Ennnnnnnnnnnnnnnnnnn/MyBalanceVehicle/Hardware/pcb.png

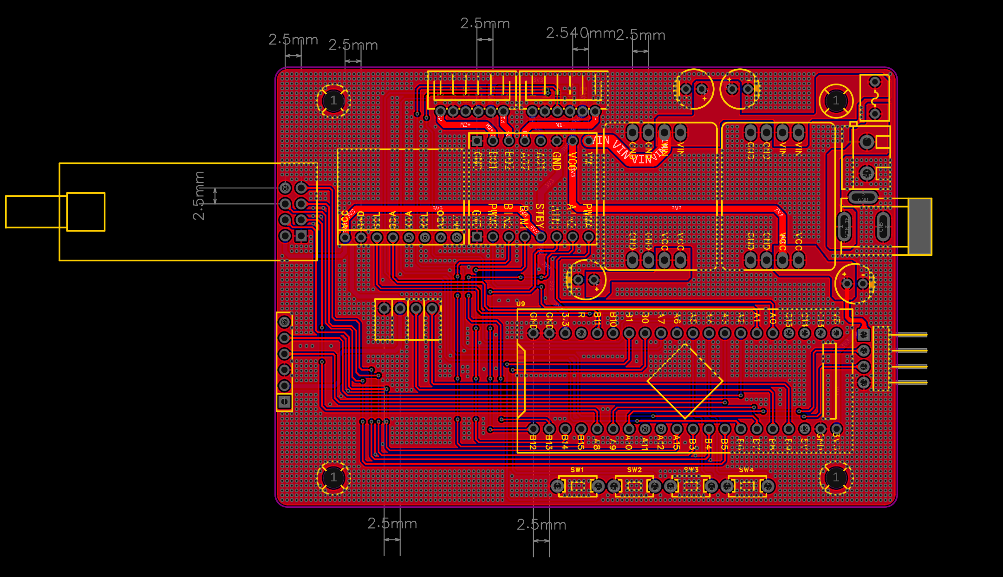
Hardware/pcb.png
