Ennnnnnnnnnnnnnnnnnn/MyBalanceVehicle/Hardware/schematic.png

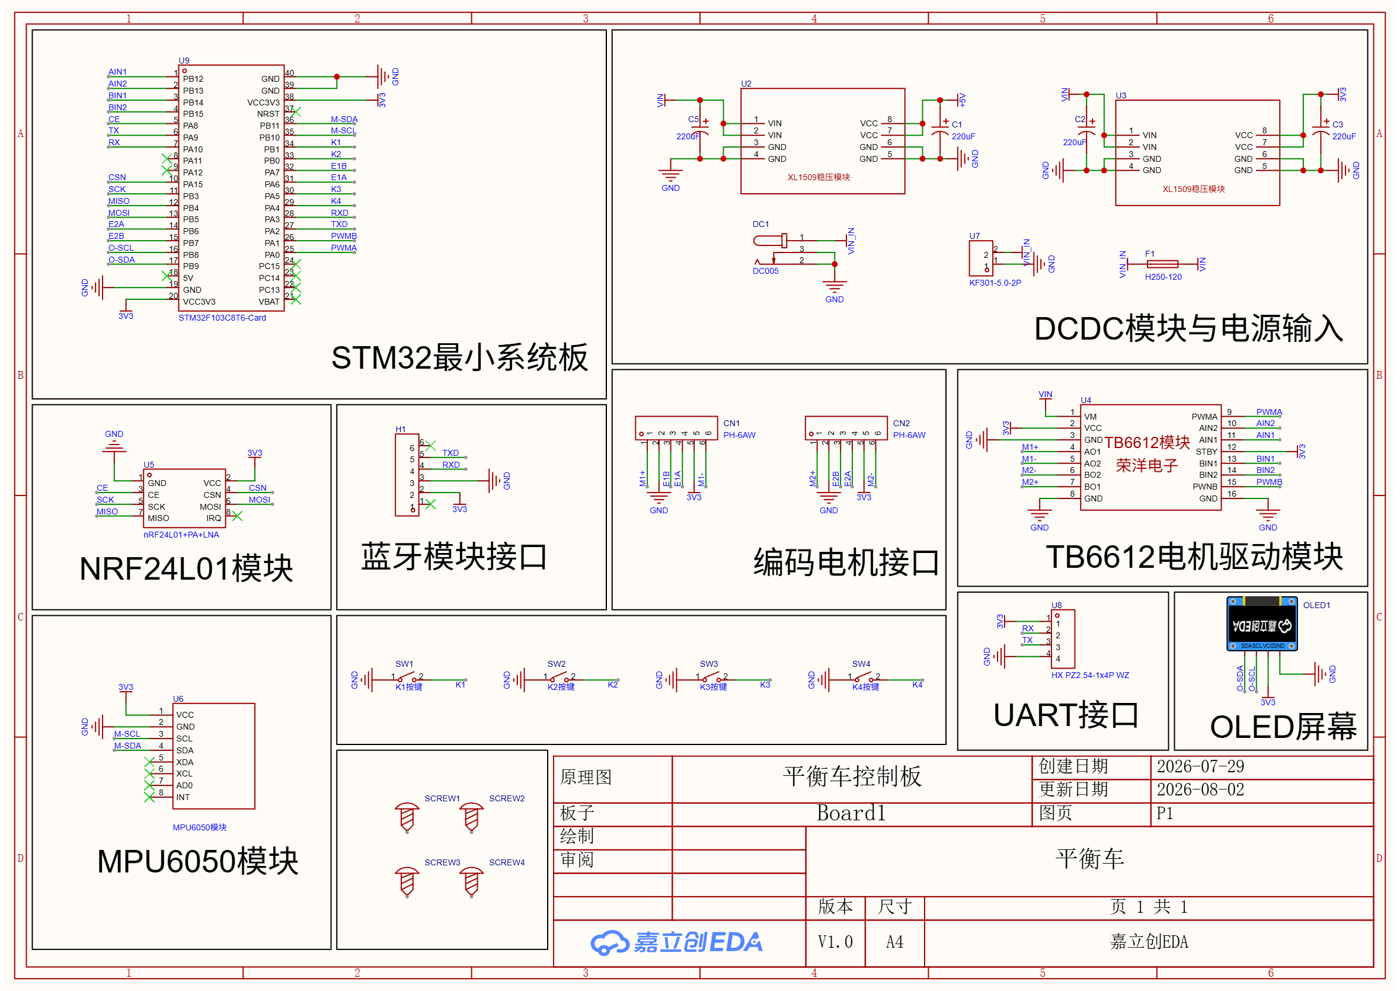
Hardware/schematic.png
