Ennnnnnnnnnnnnnnnnnn/MyBalanceVehicle/Hardware/BOM.xlsx

No. | Quantity | Comment | Designator | Footprint | Value | Manufacturer Part | Manufacturer | Supplier Part | Supplier
1 | 4 | 220uF | C1,C2,C3,C5 | CAP-TH_BD6.3-P2.50-D0.5-FD | 220uF | ERG25V220M6X11 | JIERR(捷而瑞) | C47344177 | LCSC
2 | 2 | PH-6AW | CN1,CN2 | CONN-TH_6P-P2.00_HCTL_PH-6AW |  | PH-6AW | HCTL(华灿天禄) | C2908638 | LCSC
3 | 1 | DC005 | DC1 | DC-IN-TH_DC005 |  | DC005 | SHOU HAN(首韩) | C431533 | LCSC
4 | 1 | H250-120 | F1 | FUSE-TH_L7.0-W4.5-P5.10-D0.6 |  | H250-120 | R+O(宏嘉诚) | C49166736 | LCSC
5 | 1 | HDR-F_2.54_1x6P | H1 | HDR-TH_6P-P2.54-V-F |  |  |  | C40877
6 | 1 | 0.96OLED模块_4P | OLED1 | 0.96OLED_4P
7 | 4 | M3螺丝 | SCREW1,SCREW2,SCREW3,SCREW4 | M3螺丝
8 | 1 | K1按键 | SW1 | SW-TH_L6.0-W3.3-P6.50 |  | K1按键 | Yuandi(元迪) | C492996 | LCSC
9 | 1 | K2按键 | SW2 | SW-TH_L6.0-W3.3-P6.50 |  | K2按键 | Yuandi(元迪) | C492996 | LCSC
10 | 1 | K3按键 | SW3 | SW-TH_L6.0-W3.3-P6.50 |  | K3按键 | Yuandi(元迪) | C492996 | LCSC
11 | 1 | K4按键 | SW4 | SW-TH_L6.0-W3.3-P6.50 |  | K4按键 | Yuandi(元迪) | C492996 | LCSC
12 | 2 | XL1509降压模块 | U2,U3 | XL1509-5.0降压模块
13 | 1 | TB6612模块 | U4 | tb6612模块
14 | 1 | nRF24L01+PA+LNA | U5 | COMM-TH_L41.0-W15.5-P2.54_NRF24L01 |  | nRF24L01+PA+LNA |  | C9900187674 | LCSC
15 | 1 | MPU6050模块 | U6 | MPU6050 | MPU6050模块
16 | 1 | KF301-5.0-2P | U7 | CONN-TH_P5.00_KF301-5.0-2P |  | KF301-5.0-2P | KEFA(科发) | C474881 | LCSC
17 | 1 | HX PZ2.54-1x4P WZ | U8 | HDR-TH_4P-P2.54-H-M-W10.3 |  | HX PZ2.54-1x4P WZ | hanxia(韩下) | C32713263 | LCSC
18 | 1 | STM32F103C8T6-Card | U9 | CONN-TH_L53.3-W22.9_STM32F103C8T6-CARD |  | STM32F103C8T6-Card |  | C9900077949 | LCSC
