Ennnnnnnnnnnnnnnnnnn/MyBalanceVehicle/Hardware/schematic.pdf

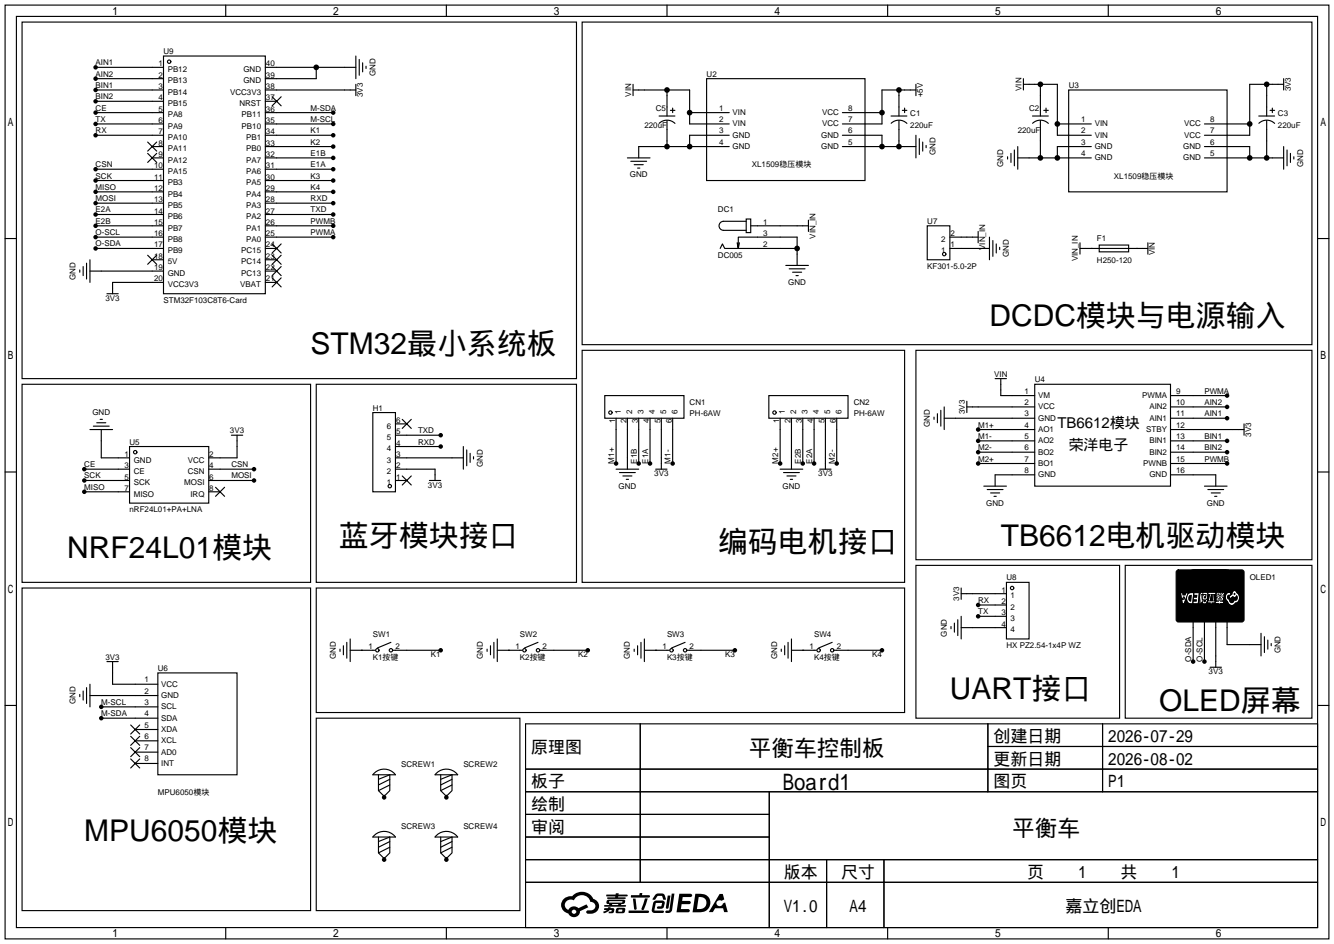
[picture p7: page 1]

原理图 | 平衡车控制板 | 创建日期 | 2026-07-29

更新日期 | 2026-08-02

板子 | Board1 | 图页 | P1
绘制 | | 平衡车
审阅

V1.0 | A4 | 嘉立创EDA
