Ennnnnnnnnnnnnnnnnnn/MyBalanceVehicle/3program optimization/Hardware/Motor.c

#include "stm32f10x.h"                  // Device header
#include "PWM.h"

void Motor_Init(void)
{
	RCC_APB2PeriphClockCmd(RCC_APB2Periph_GPIOB,ENABLE);
	GPIO_InitTypeDef GPIO_InitStructure;
	GPIO_InitStructure.GPIO_Mode=GPIO_Mode_Out_PP;
	GPIO_InitStructure.GPIO_Pin=GPIO_Pin_12|GPIO_Pin_13|GPIO_Pin_14|GPIO_Pin_15;
	GPIO_InitStructure.GPIO_Speed=GPIO_Speed_50MHz;
	GPIO_Init(GPIOB,&GPIO_InitStructure);
	
	PWM_Init();
}

void Motor_SetSpeed(uint8_t n,int8_t speed)
{
	if(n==1)
	{
		if(speed>=0)
		{
			GPIO_SetBits(GPIOB,GPIO_Pin_12);
			GPIO_ResetBits(GPIOB,GPIO_Pin_13);
			PWM1_SetCompare1(speed);
			
		}	
		else
		{
			GPIO_ResetBits(GPIOB,GPIO_Pin_12);
			GPIO_SetBits(GPIOB,GPIO_Pin_13);
			PWM1_SetCompare1(-speed);
		}
	}
	else if(n==2)
	{
		if(speed>=0)
		{
			GPIO_ResetBits(GPIOB,GPIO_Pin_14);
			GPIO_SetBits(GPIOB,GPIO_Pin_15);
			PWM1_SetCompare2(speed);
			
		}	
		else
		{
			GPIO_SetBits(GPIOB,GPIO_Pin_14);
			GPIO_ResetBits(GPIOB,GPIO_Pin_15);
			PWM1_SetCompare2(-speed);
		}
	}
	
	
}
