Ennnnnnnnnnnnnnnnnnn/MyBalanceVehicle/3program optimization/Hardware/Key.c

#include "stm32f10x.h"                  // Device header
#include "Delay.h"

uint8_t Key_Num;

void Key_Init(void)
{
	RCC_APB2PeriphClockCmd(RCC_APB2Periph_GPIOB,ENABLE);
	RCC_APB2PeriphClockCmd(RCC_APB2Periph_GPIOA,ENABLE);
	GPIO_InitTypeDef GPIO_InitStructure;
	GPIO_InitStructure.GPIO_Mode=GPIO_Mode_IPU;
	GPIO_InitStructure.GPIO_Pin=GPIO_Pin_1|GPIO_Pin_0;
	GPIO_InitStructure.GPIO_Speed=GPIO_Speed_50MHz;
	GPIO_Init(GPIOB,&GPIO_InitStructure);
	GPIO_InitStructure.GPIO_Mode=GPIO_Mode_IPU;
	GPIO_InitStructure.GPIO_Pin=GPIO_Pin_5|GPIO_Pin_4;
	GPIO_InitStructure.GPIO_Speed=GPIO_Speed_50MHz;
	GPIO_Init(GPIOA,&GPIO_InitStructure);
	
}

uint8_t Key_GetNum(void)
{
	uint8_t temp;
	if(Key_Num)
	{
		temp=Key_Num;
		Key_Num=0;
		return temp;
	}
	return 0;
}

uint8_t Key_GetState(void)
{
	if(GPIO_ReadInputDataBit(GPIOB,GPIO_Pin_1)==0)
		return 1;
	if(GPIO_ReadInputDataBit(GPIOB,GPIO_Pin_0)==0)
		return 2;
	if(GPIO_ReadInputDataBit(GPIOA,GPIO_Pin_5)==0)
		return 3;
	if(GPIO_ReadInputDataBit(GPIOA,GPIO_Pin_4)==0)
		return 4;
	
	
	
	return 0;
}

void Key_Tick(void)
{
	static uint8_t Count;
	static uint8_t CurrState,PrevState;
	
	Count++;
	if(Count>=20)
	{
		Count=0;
		PrevState=CurrState;
		CurrState=Key_GetState();
		
		if((CurrState==0)&&(PrevState!=0))
		{
			Key_Num=PrevState;
		}
	}
}
