Ennnnnnnnnnnnnnnnnnn/MyBalanceVehicle/3program optimization/Hardware/PWM.c

#include "stm32f10x.h"                  // Device header


void PWM_Init(void)
{
	RCC_APB1PeriphClockCmd(RCC_APB1Periph_TIM2,ENABLE);
	RCC_APB2PeriphClockCmd(RCC_APB2Periph_GPIOA,ENABLE);
	
//	RCC_APB2PeriphClockCmd(RCC_APB2Periph_AFIO,ENABLE);
//	GPIO_PinRemapConfig(GPIO_PartialRemap1_TIM2,ENABLE);
//	GPIO_PinRemapConfig(GPIO_Remap_SWJ_JTAGDisable,ENABLE);
	
	GPIO_InitTypeDef GPIO_InitStructure;
	GPIO_InitStructure.GPIO_Mode=GPIO_Mode_AF_PP;
	GPIO_InitStructure.GPIO_Pin=GPIO_Pin_0|GPIO_Pin_1;  //GPIO_Pin_15
	GPIO_InitStructure.GPIO_Speed=GPIO_Speed_50MHz;
	GPIO_Init(GPIOA,&GPIO_InitStructure);
	
	TIM_InternalClockConfig(TIM2);
	
	TIM_TimeBaseInitTypeDef TimeBaseInitStructure;
	TimeBaseInitStructure.TIM_ClockDivision=TIM_CKD_DIV1;
	TimeBaseInitStructure.TIM_CounterMode=TIM_CounterMode_Up;
	TimeBaseInitStructure.TIM_Period=100-1;//PSC
	TimeBaseInitStructure.TIM_Prescaler=36-1;//ARR
	TimeBaseInitStructure.TIM_RepetitionCounter=0;
	TIM_TimeBaseInit(TIM2,&TimeBaseInitStructure);
	TIM_ClearFlag(TIM2,TIM_FLAG_Update);
	
	TIM_OCInitTypeDef TIM_OCInitStructure;
	TIM_OCStructInit(&TIM_OCInitStructure);
	TIM_OCInitStructure.TIM_OCMode=TIM_OCMode_PWM1;
	TIM_OCInitStructure.TIM_OCPolarity=TIM_OCPolarity_High;
	TIM_OCInitStructure.TIM_OutputState=TIM_OutputState_Enable;
	TIM_OCInitStructure.TIM_Pulse=0;
	TIM_OC1Init(TIM2,&TIM_OCInitStructure);
	TIM_OC2Init(TIM2,&TIM_OCInitStructure);
	
	
	TIM_Cmd(TIM2,ENABLE);
}

void PWM1_SetCompare1(uint16_t Compare)
{
	TIM_SetCompare1(TIM2,Compare);

}

void PWM1_SetCompare2(uint16_t Compare)
{
	TIM_SetCompare2(TIM2,Compare);

}
