Ennnnnnnnnnnnnnnnnnn/MyBalanceVehicle/3program optimization/system/Timer.c

#include "stm32f10x.h"                  // Device header

//extern uint16_t num;//不声明的话就直接把中断函数放在主函数后面
void Timer_Init(void)
{
	RCC_APB2PeriphClockCmd(RCC_APB2Periph_TIM1,ENABLE);
	
	TIM_InternalClockConfig(TIM1);//默认使用的也是内部时钟，这行可不写
	
	TIM_TimeBaseInitTypeDef TimeBaseInitStructure;
	TimeBaseInitStructure.TIM_ClockDivision=TIM_CKD_DIV1;
	TimeBaseInitStructure.TIM_CounterMode=TIM_CounterMode_Up;
	TimeBaseInitStructure.TIM_Period=1000-1;//PSC
	TimeBaseInitStructure.TIM_Prescaler=72-1;//ARR
	TimeBaseInitStructure.TIM_RepetitionCounter=0;
	TIM_TimeBaseInit(TIM1,&TimeBaseInitStructure);
	TIM_ClearFlag(TIM1,TIM_FLAG_Update);
	
	TIM_ITConfig(TIM1,TIM_IT_Update,ENABLE);
	
	NVIC_PriorityGroupConfig(NVIC_PriorityGroup_2);
	
	NVIC_InitTypeDef NVIC_InitStructure;
	NVIC_InitStructure.NVIC_IRQChannel=TIM1_UP_IRQn;
	NVIC_InitStructure.NVIC_IRQChannelCmd=ENABLE;
	NVIC_InitStructure.NVIC_IRQChannelPreemptionPriority=2;
	NVIC_InitStructure.NVIC_IRQChannelSubPriority=1;
	NVIC_Init(&NVIC_InitStructure);
	
	TIM_Cmd(TIM1,ENABLE);
}

//void TIM1_UP_IRQHandler(void)
//{
//	if(TIM_GetITStatus(TIM1,TIM_IT_Update)==SET)
//	{
//		
//		TIM_ClearITPendingBit(TIM1,TIM_IT_Update);
//	}
//}
