Ennnnnnnnnnnnnnnnnnn/MyBalanceVehicle/(commit log)

2026-10-14 1. `add 1 pitch angle & complementary filter`
2026-10-14 add 2 three-loop PID control
2026-10-14 Add README for STM32 balance vehicle project
2026-10-14 Add language switch link
2026-10-14 Add hardware design files: schematic, PCB and BOM
    [BOM.xlsx]
